hpvdt/zypher/README.md

# Zypher
Code and CAD of our 2019 ASME electronics system. Electronics hardware was designed in EAGLE, microcontroller code was prepared using the Arduino IDE. A mobile app prepared in MIT App Inventer 2 was used as the primary user interface.
