hpvdt/zypher/Hardware/Lighting line claculations.xlsx

Sheet: Sheet1
 |  | LED V Drop (V) |  |  | Peak Power (W) |  |  |  |  |  | Ref | 0.2
Light | LEDs Required | Min | Max | Peak Current (A) | Min | Max | Lines Required | LEDs per Line | Max V drop | Total Current to lights | Resistance needed on reg | Power across resistors | 95% power | Resistance needed on reg | Power across resistors
Head | 8 | 3.20 | 3.40 | 0.3500 | 1.12 | 1.19 | 1 | 8 | 27.20 | 0.350 | 0.571 | 0.07 | 0.332 | 0.602 | 0.07
High Beam | 2 | 9.00 | 12.00 | 1.0500 | 9.45 | 12.60 | 1 | 2 | 24.00 | 1.050 | 0.190 | 0.21 | 0.997 | 0.201 | 0.20
Left Ind. | 8 | 2.00 | 2.20 | 0.2625 | 0.53 | 0.58 | 1 | 8 | 17.60 | 0.263 | 0.762 | 0.05 | 0.249 | 0.802 | 0.05
Right Ind. | 8 | 2.00 | 2.20 | 0.2625 | 0.53 | 0.58 | 1 | 8 | 17.60 | 0.263 | 0.762 | 0.05 | 0.249 | 0.802 | 0.05
Tail | 8 | 1.70 | 1.90 | 0.2625 | 0.45 | 0.50 | 1 | 8 | 15.20 | 0.263 | 0.762 | 0.05 | 0.249 | 0.802 | 0.05
 |  |  |  |  |  |  |  |  | 28.45 | Max V
 | Max | Min
Battery V: | 12.3 | 11.1 | V | Power alloance | Max I | Min Resis |  |  | Res I have | Power | Current
 |  |  | 1.25 | 0.01 | 0.008 | 156.25 |  |  | 0.33 | 5 | 0.6060606061 |  |  | 1.400 | 3.143 | 6.16
I | R1 | R2 |  | 0.025 | 0.020 | 62.50 |  |  | 0.91 | 3 | 0.2197802198 |  |  | 3.000 | 1.467 | 13.20
3 | 0.6 | 1.363636364 |  | 0.03 | 0.024 | 52.08 |  |  | 1.2 | 3 | 0.1666666667 |  |  | 0.525 | 8.381 | 2.31
I indep | 2.0833 | 0.9167 |  | 0.04 | 0.032 | 39.06 |  |  | 2.4 | 2 | 0.08333333333
P indep | 2.604166667 | 1.145833333 |  | 0.05 | 0.040 | 31.25 |  |  | 190 |  | 1.052631579
 |  |  |  | 0.1 | 0.080 | 15.62
 |  |  |  | 0.125 | 0.100 | 12.50
 |  |  |  | 0.15 | 0.120 | 10.42
 |  |  |  | 0.2 | 0.160 | 7.81
 |  |  |  | 0.3 | 0.240 | 5.21
 |  |  |  | 0.333 | 0.266 | 4.69
 |  |  |  | 0.4 | 0.320 | 3.91
 |  |  |  | 0.5 | 0.400 | 3.12
 |  |  |  | 1 | 0.800 | 1.56

Sheet: Step Up
Vref | 1.23 | LED V Drop (V) |  |  | Peak Power (W)
Light | LEDs Required | Min | Max | Peak Current (A) | Min | Max | Lines Required | LEDs per Line | Max V drop | Total Current to lights | Resistance needed on reg | Power across resistors | Vout from step up | Max Current possible | R sense | D max | ET | I ind | L min (uH) | Spec Inductor
Head | 8 | 3.20 | 3.40 | 0.3500 | 1.12 | 1.19 | 1 | 8 | 27.20 | 0.350 | 3.51 | 0.43 | 28.43 | 0.776 | 3.514 | 0.651 | 123.8541638 | 2.330410418 | 54.592 | H220
High Beam | 2 | 9.00 | 12.00 | 1.0500 | 9.45 | 12.60 | 1 | 2 | 24.00 | 1.050 | 1.17 | 1.29 | 25.23 | 0.874 | 1.407 | 0.606 | 115.3823196 | 2.329367095 | 34.112 | H220
Left Ind. | 4 | 2.00 | 2.20 | 0.2625 | 0.53 | 0.58 | 1 | 4 | 8.80 | 0.263 | 4.69 | 0.32
Right Ind. | 4 | 2.00 | 2.20 | 0.2625 | 0.53 | 0.58 | 1 | 4 | 8.80 | 0.263 | 4.69 | 0.32
Tail | 8 | 1.70 | 1.90 | 0.2625 | 0.45 | 0.50 | 1 | 8 | 15.20 | 0.263 | 4.69 | 0.32 | 16.43 | 1.342 | 4.686 | 0.394 | 74.96467097 | 2.324402424 | -22.208 | H150
 |  |  |  |  |  |  |  |  | 28.45 | Max V |  |  |  |  | Vf | 0.5
 | Max | Min
Battery V: | 12.3 | 10.5 | V | Power alloance | Max I | Min Resis |  |  | Res I have | Power
 |  |  | 1.25 | 0.01 | 0.008 | 156.25 |  |  | 0.33 | 5
I | R1 | R2 |  | 0.025 | 0.020 | 62.50 |  |  | 0.91 | 3
3 | 0.6 | 1.363636364 |  | 0.03 | 0.024 | 52.08 |  |  | 1.2 | 3
I indep | 2.0833 | 0.9167 |  | 0.04 | 0.032 | 39.06 |  |  | 2.4 | 2
P indep | 2.604166667 | 1.145833333 |  | 0.05 | 0.040 | 31.25
 |  |  |  | 0.1 | 0.080 | 15.62
 |  |  |  | 0.125 | 0.100 | 12.50
 |  |  |  | 0.15 | 0.120 | 10.42
 |  |  |  | 0.2 | 0.160 | 7.81
 |  |  |  | 0.3 | 0.240 | 5.21
 |  |  |  | 0.333 | 0.266 | 4.69
 |  |  |  | 0.4 | 0.320 | 3.91
 |  |  |  | 0.5 | 0.400 | 3.12
 |  |  |  | 1 | 0.800 | 1.56
