hpvdt/zypher/Hardware/Zypher PCB.brd

## EAGLE design Hardware/Zypher PCB.brd (2019-11-08)

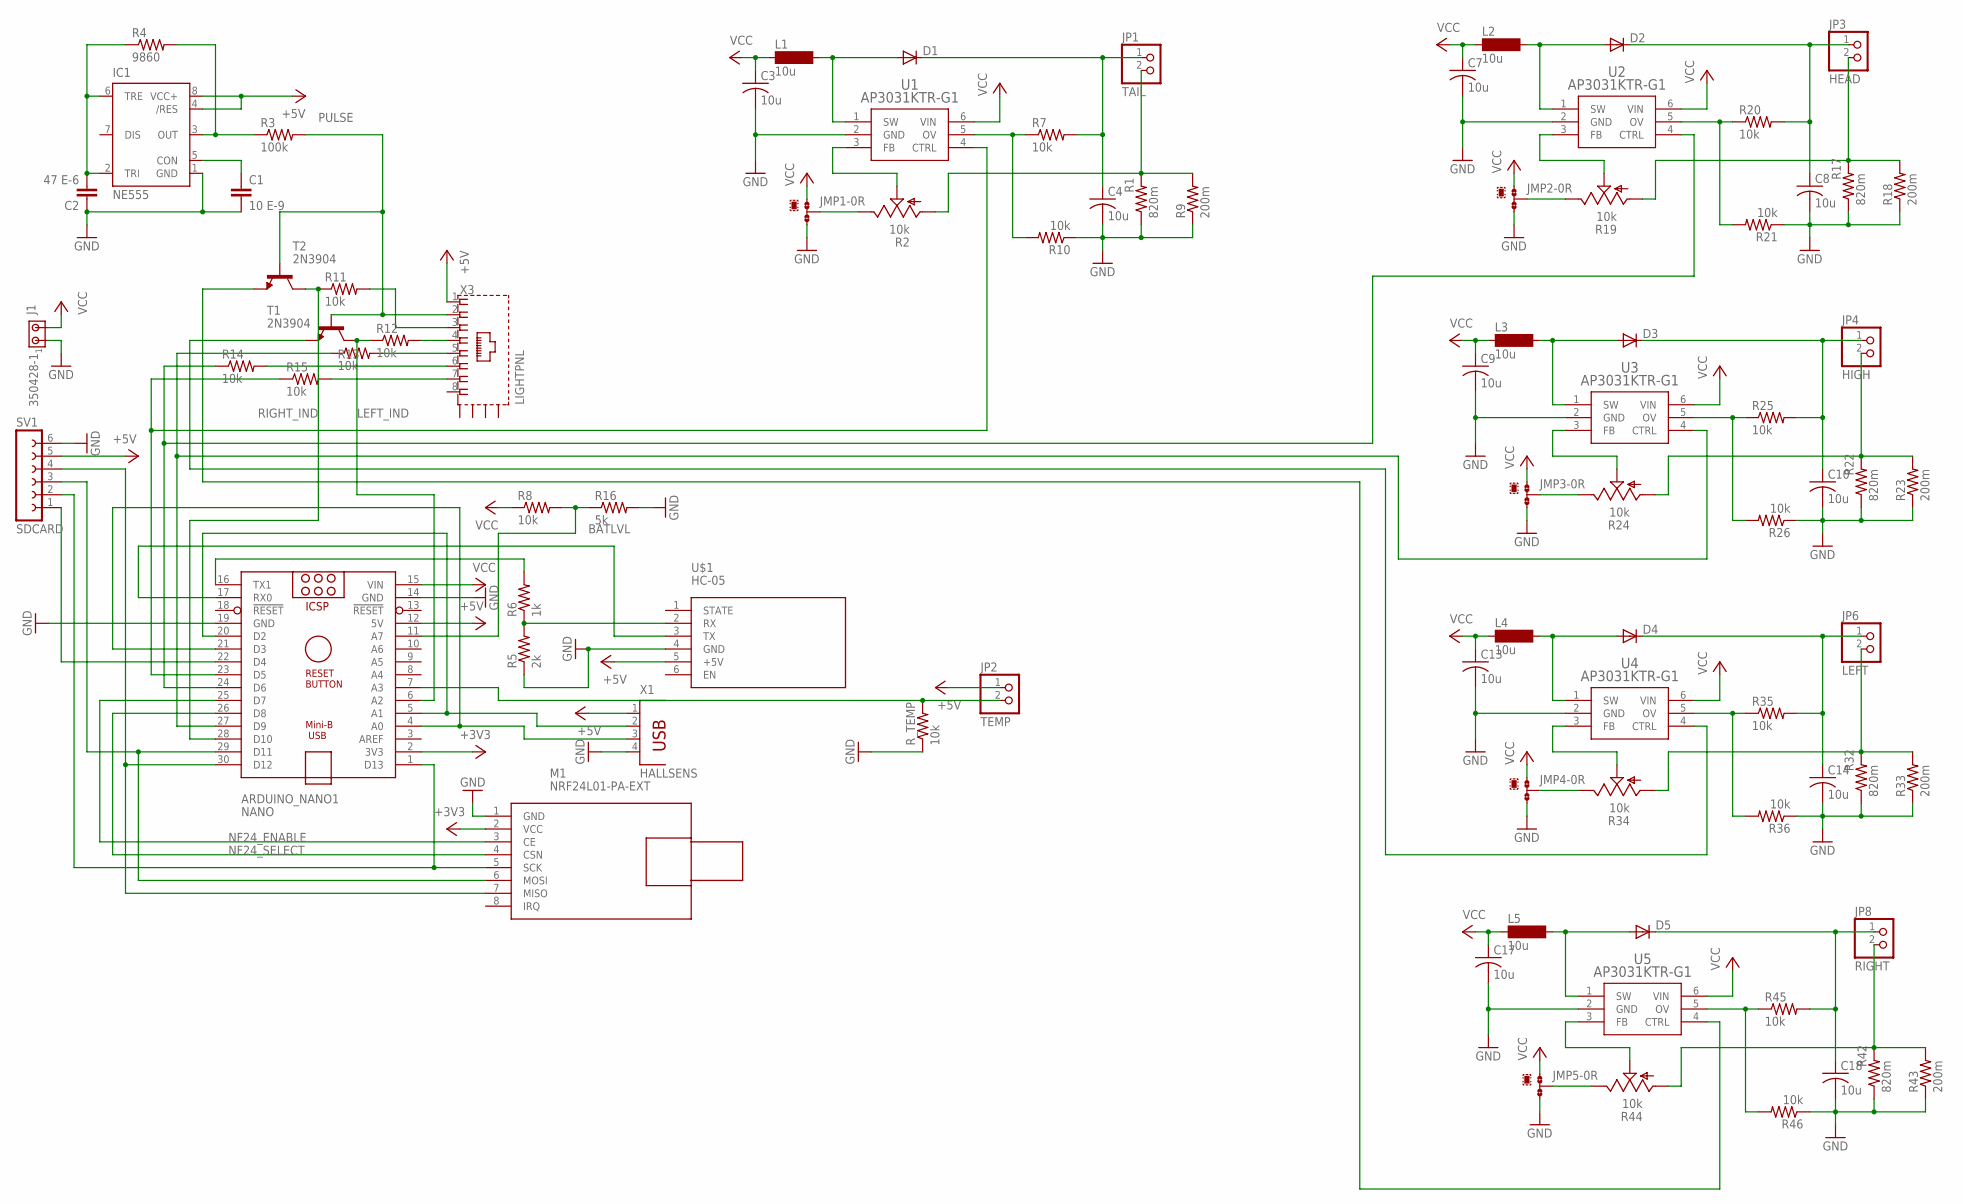
[picture p1: schematic Zypher PCB.sch]

Parts:
ARDUINO_NANO1: NANO; ARDUINO_NANO
C1: 10 E-9; C2.5-5
C2: 47 E-6; C2.5-5
C3, C4, C7, C8, C9, C10, C13, C14, C17, C18: 10u; C1206K
D1, D2, D3, D4, D5: DIODE-DO-214AC; DO-214AC
IC1: NE555; DIL-08
J1: 350428-1
JMP1, JMP2, JMP3, JMP4, JMP5: 0R-JUMPA; A0R-JMP
JP1: TAIL; 1X02
JP2: TEMP; 1X02
JP3: HEAD; 1X02
JP4: HIGH; 1X02
JP6: LEFT; 1X02
JP8: RIGHT; 1X02
L1, L2, L3, L4, L5: 10u; SD12K100
M1: NRF24L01-PA-EXT; WIRELESS-NRF24L01-PA-EXT
R1, R17, R22, R32, R42: 820m; R0603
R2, R19, R24, R34, R44: 10k; RJ9W
R3: 100k; 0207/7
R4: 9860; 0207/7
R5: 2k; 0204/7
R6: 1k; 0204/7
R7, R10, R20, R21, R25, R26, R35, R36, R45, R46: 10k; 0207/2V
R8, R11, R12, R13, R14, R15: 10k; 0207/7
R9, R18, R23, R33, R43: 200m; R0805
R16: 5k; 0207/7
R_TEMP: 10k; 0207/7
SV1: SDCARD; FE06W
T1, T2: 2N3904; TO92
U1, U2, U3, U4, U5: AP3031KTR-G1; SOT23-6
U$1: HC-05; WIRELESS-BLUETOOTH-HC-05
X1: HALLSENS; PN87520
X3: LIGHTPNL; RJ45-SHIELD1

Connections:
+3V3: ARDUINO_NANO1.2 (3V3), M1.2 (VCC)
+5V: ARDUINO_NANO1.12 (5V), IC1.4 (/RES), IC1.8 (VCC+), JP2.1, SV1.5, U$1.5 (+5V), X1.1, X3.1
BATLVL: ARDUINO_NANO1.11 (A7), R8.2, R16.1
CLK: ARDUINO_NANO1.1 (D13), M1.5 (SCK), SV1.2
GND: ARDUINO_NANO1.14 (GND), ARDUINO_NANO1.19 (GND), C1.2, C2.1, C3.2, C4.2, C7.2, C8.2, C9.2, C10.2, C13.2, C14.2, C17.2, C18.2, IC1.1 (GND), J1.1, JMP1.3, JMP2.3, JMP3.3, JMP4.3, JMP5.3, M1.1 (GND), R1.1, R5.1, R9.1, R10.1, R16.2, R17.1, R18.1, R21.1, R22.1, R23.1, R26.1, R32.1, R33.1, R36.1, R42.1, R43.1, R46.1, R_TEMP.1, SV1.6, U1.2 (GND), U2.2 (GND), U3.2 (GND), U4.2 (GND), U5.2 (GND), U$1.4 (GND), X1.4
HALL1: ARDUINO_NANO1.4 (A0), ARDUINO_NANO1.21 (D3), X1.3
HALL2: ARDUINO_NANO1.5 (A1), ARDUINO_NANO1.20 (D2), X1.2
HEAD_CTRL: ARDUINO_NANO1.24 (D6), R14.1, U2.4 (CTRL)
HIGH_CTRL: ARDUINO_NANO1.27 (D9), R13.1, U3.4 (CTRL)
LEFT+: C14.1, D4.C, JP6.1, R35.2
LEFT-: JP6.2, R32.2, R33.2, R34.A
LEFT_CTRL: T1.3 (E), U4.4 (CTRL)
LEFT_IND: ARDUINO_NANO1.6 (A2), R12.1, T1.1 (C)
MISO: ARDUINO_NANO1.30 (D12), M1.7 (MISO), SV1.4
MOSI: ARDUINO_NANO1.29 (D11), M1.6 (MOSI), SV1.3
unnamed: D1.A, L1.2, U1.1 (SW)
unnamed: C1.1, IC1.5 (CON)
unnamed: C4.1, D1.C, JP1.1, R7.2
unnamed: C2.2, IC1.2 (TRI), IC1.6 (TRE), R4.1
unnamed: IC1.3 (OUT), R3.1, R4.2
unnamed: R2.S, U1.3 (FB)
unnamed: JP1.2, R1.2, R2.A, R9.2
unnamed: JMP1.2, R2.E
unnamed: R5.2, R6.1, U$1.2 (RX)
unnamed: R7.1, R10.2, U1.5 (OV)
unnamed: R14.2, X3.6
unnamed: R13.2, X3.5
unnamed: R11.2, X3.3
unnamed: R12.2, X3.4
unnamed: R15.2, X3.7
unnamed: D2.A, L2.2, U2.1 (SW)
unnamed: C8.1, D2.C, JP3.1, R20.2
unnamed: JP3.2, R17.2, R18.2, R19.A
unnamed: R19.S, U2.3 (FB)
unnamed: JMP2.2, R19.E
unnamed: R20.1, R21.2, U2.5 (OV)
unnamed: D3.A, L3.2, U3.1 (SW)
unnamed: C10.1, D3.C, JP4.1, R25.2
unnamed: JP4.2, R22.2, R23.2, R24.A
unnamed: R24.S, U3.3 (FB)
unnamed: JMP3.2, R24.E
unnamed: R25.1, R26.2, U3.5 (OV)
unnamed: D4.A, L4.2, U4.1 (SW)
unnamed: R34.S, U4.3 (FB)
unnamed: JMP4.2, R34.E
unnamed: R35.1, R36.2, U4.5 (OV)
unnamed: D5.A, L5.2, U5.1 (SW)
unnamed: R44.S, U5.3 (FB)
unnamed: JMP5.2, R44.E
unnamed: R45.1, R46.2, U5.5 (OV)
NF24_ENABLE: ARDUINO_NANO1.25 (D7), M1.3 (CE)
NF24_SELECT: ARDUINO_NANO1.26 (D8), M1.4 (CSN)
PULSE: R3.2, T1.2 (B), T2.2 (B), X3.2
RIGHT+: C18.1, D5.C, JP8.1, R45.2
RIGHT-: JP8.2, R42.2, R43.2, R44.A
RIGHT_CTRL: T2.3 (E), U5.4 (CTRL)
RIGHT_IND: ARDUINO_NANO1.28 (D10), R11.1, T2.1 (C)
RX: ARDUINO_NANO1.17 (RX0), U$1.3 (TX)
SD_SEL: ARDUINO_NANO1.22 (D4), SV1.1
TAIL_CTRL: ARDUINO_NANO1.23 (D5), R15.1, U1.4 (CTRL)
TEMP: ARDUINO_NANO1.7 (A3), JP2.2, R_TEMP.2
TX: ARDUINO_NANO1.16 (TX1), R6.2
VCC: ARDUINO_NANO1.15 (VIN), C3.1, C7.1, C9.1, C13.1, C17.1, J1.2, JMP1.1, JMP2.1, JMP3.1, JMP4.1, JMP5.1, L1.1, L2.1, L3.1, L4.1, L5.1, R8.1, U1.6 (VIN), U2.6 (VIN), U3.6 (VIN), U4.6 (VIN), U5.6 (VIN)

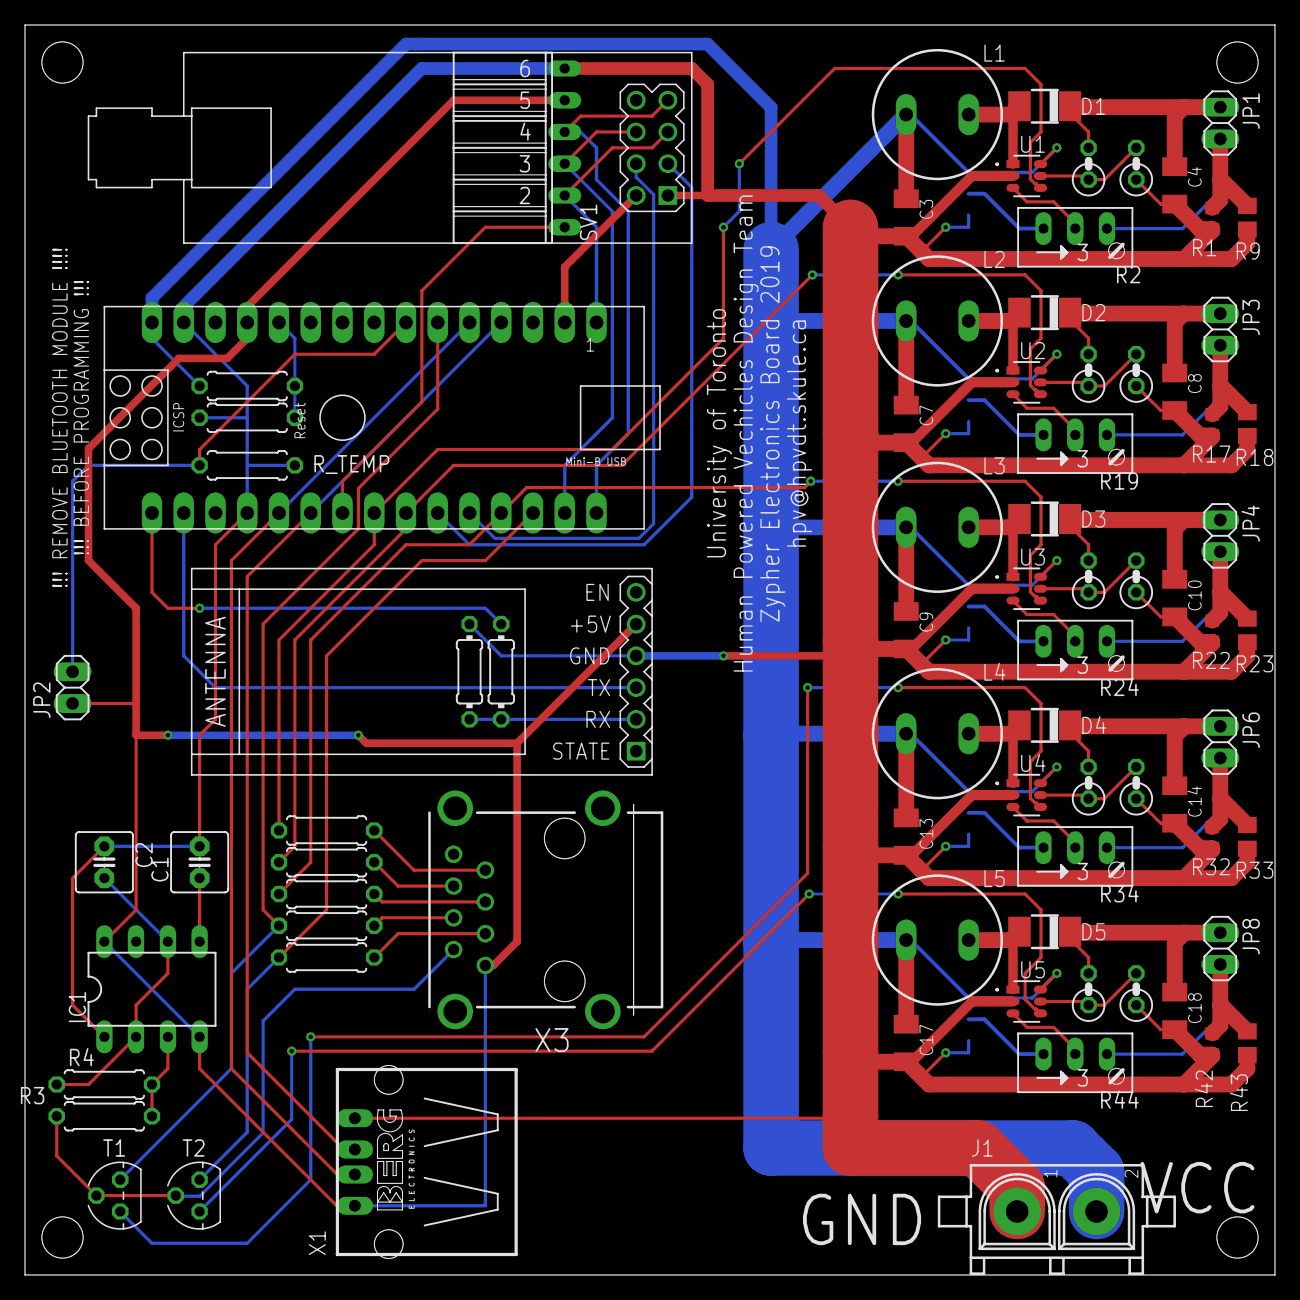
[picture p2: board Zypher PCB.brd from above]

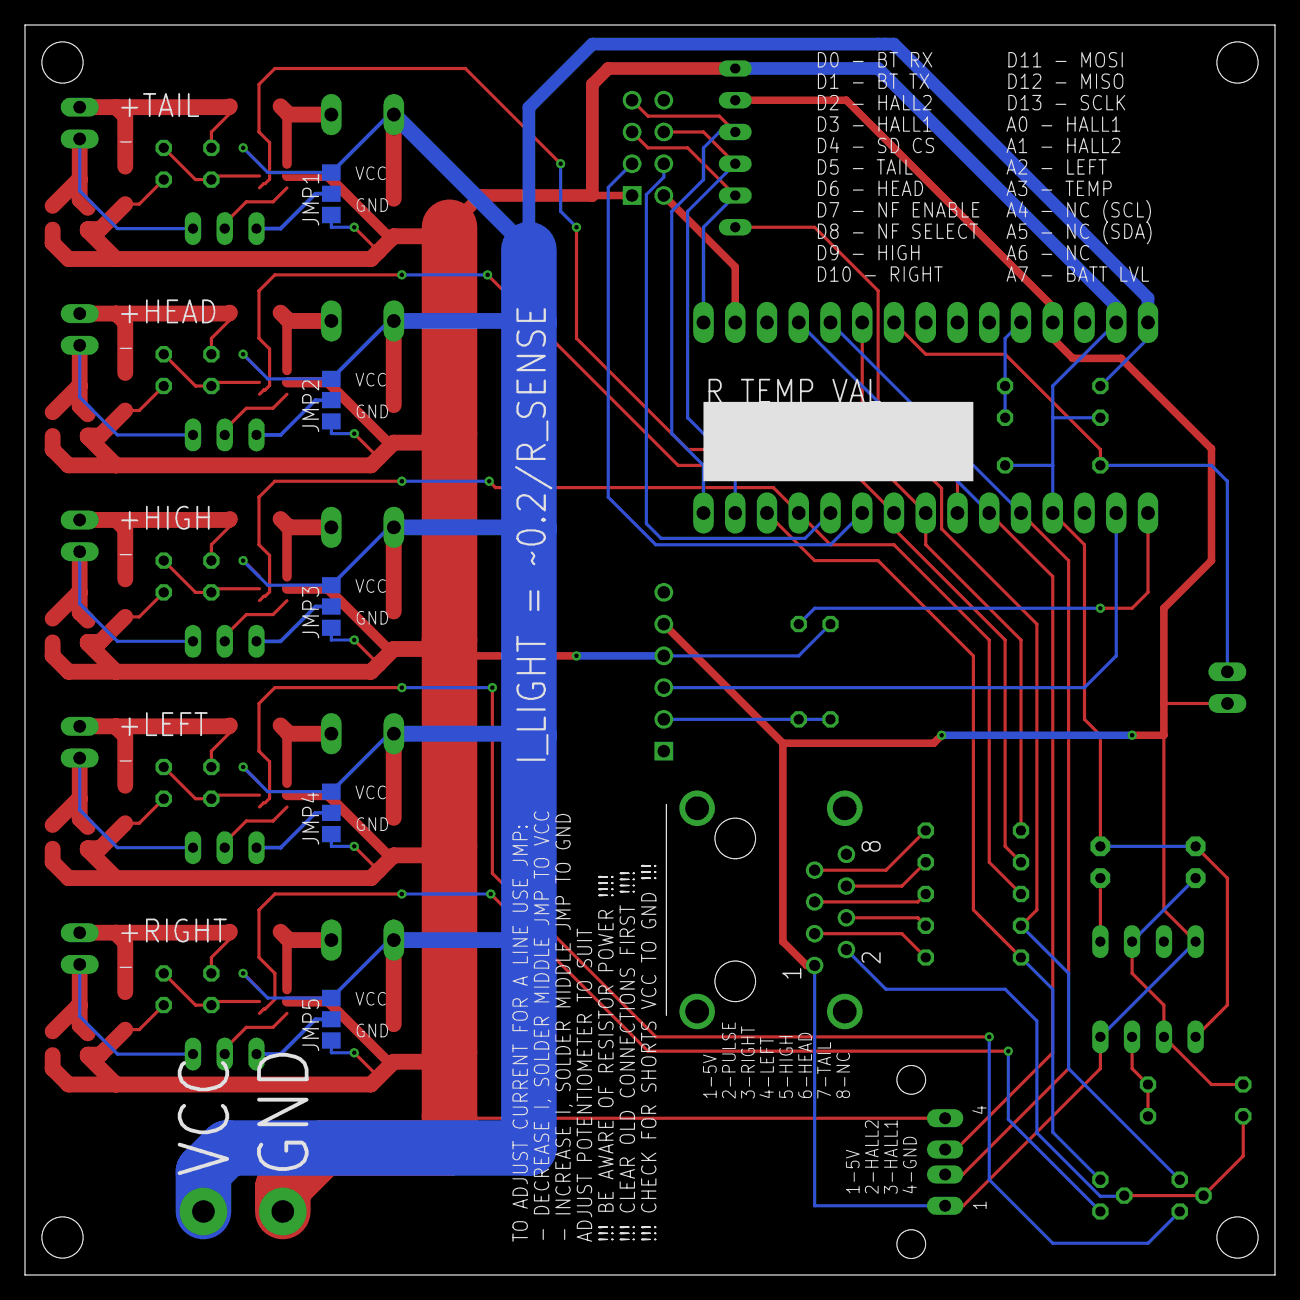
[picture p3: board Zypher PCB.brd from below]

Board: 2 copper layers, 100.0 x 100.0 mm, 85 parts (5 on the bottom side), 63 nets.
