hpvdt/zypher/Hardware/Lighting Schematic.brd

## EAGLE design Hardware/Lighting Schematic.brd (2019-11-08)

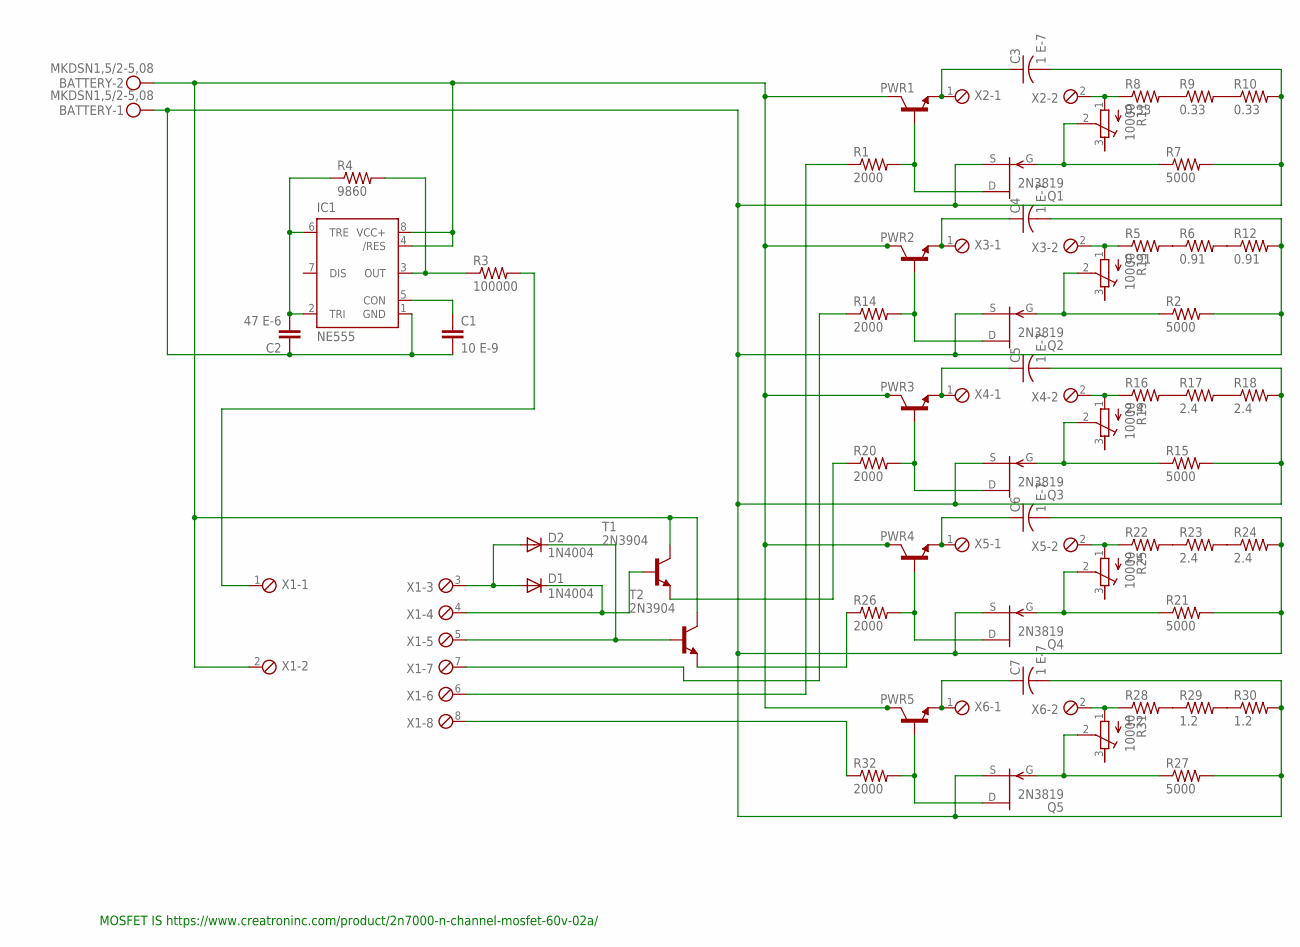
[picture p4: schematic Lighting Schematic.sch]

Parts:
BATTERY: MKDSN1,5/2-5,08
C1: 10 E-9; C2.5-5
C2: 47 E-6; C2.5-5
C3, C4, C5, C6, C7: 1 E-7; C075-052X106
D1, D2: 1N4004; DO41-10
IC1: NE555; DIL-08
PWR1, PWR2, PWR3, PWR4, PWR5: -NPN-TO220V; TO220V
Q1, Q2, Q3, Q4, Q5: 2N3819; TO92
R1, R14, R20, R26, R32: 2000; 0207/15
R2, R7, R15, R21, R27: 5000; 0207/10
R3: 100000; 0207/10
R4: 9860; 0207/10
R5, R6, R12: 0.91; P0817V
R8, R9, R10: 0.33; P0817V
R11, R13, R19, R25, R31: 10000; RTRIM3296W
R16, R17, R18, R22, R23, R24: 2.4; P0817V
R28, R29, R30: 1.2; P0817V
T1, T2: 2N3904; TO92
X1: MPT8; 8POL254
X2, X3, X4, X5, X6: MPT2; 2POL254

Connections:
GND: BATTERY.1, C1.2, C2.1, C3.2, C4.2, C5.2, C6.2, C7.2, IC1.1 (GND), Q1.3 (S), Q2.3 (S), Q3.3 (S), Q4.3 (S), Q5.3 (S), R2.2, R7.2, R10.2, R12.2, R15.2, R18.2, R21.2, R24.2, R27.2, R30.2
HEAD+: C4.1, PWR2.3 (E), X3.1
HEAD-: R5.1, R13.1 (A), X3.2
HIGH+: C3.1, PWR1.3 (E), X2.1
HIGH-: R8.1, R11.1 (A), X2.2
LEFT+: C5.1, PWR3.3 (E), X4.1
LEFT-: R16.1, R19.1 (A), X4.2
unnamed: R5.2, R6.1
unnamed: C1.1, IC1.5 (CON)
unnamed: R6.2, R12.1
unnamed: C2.2, IC1.2 (TRI), IC1.6 (TRE), R4.1
unnamed: IC1.3 (OUT), R3.1, R4.2
unnamed: D1.A, D2.A, X1.3
unnamed: D1.C, T1.2 (B), X1.4
unnamed: D2.C, T2.2 (B), X1.5
unnamed: R3.2, X1.1
unnamed: R8.2, R9.1
unnamed: R9.2, R10.1
unnamed: PWR1.1 (B), Q1.1 (D), R1.2
unnamed: Q1.2 (G), R7.1, R11.2 (S)
unnamed: PWR2.1 (B), Q2.1 (D), R14.2
unnamed: Q2.2 (G), R2.1, R13.2 (S)
unnamed: R1.1, X1.6
unnamed: R14.1, X1.7
unnamed: R26.1, T2.3 (E)
unnamed: R32.1, X1.8
unnamed: R16.2, R17.1
unnamed: R17.2, R18.1
unnamed: PWR3.1 (B), Q3.1 (D), R20.2
unnamed: Q3.2 (G), R15.1, R19.2 (S)
unnamed: R22.2, R23.1
unnamed: R23.2, R24.1
unnamed: PWR4.1 (B), Q4.1 (D), R26.2
unnamed: Q4.2 (G), R21.1, R25.2 (S)
unnamed: R28.2, R29.1
unnamed: R29.2, R30.1
unnamed: PWR5.1 (B), Q5.1 (D), R32.2
unnamed: Q5.2 (G), R27.1, R31.2 (S)
unnamed: R20.1, T1.3 (E)
RIGHT+: C6.1, PWR4.3 (E), X5.1
RIGHT-: R22.1, R25.1 (A), X5.2
TAIL+: C7.1, PWR5.3 (E), X6.1
TAIL-: R28.1, R31.1 (A), X6.2
VCC: BATTERY.2, IC1.4 (/RES), IC1.8 (VCC+), PWR1.2 (C), PWR2.2 (C), PWR3.2 (C), PWR4.2 (C), PWR5.2 (C), T1.1 (C), T2.1 (C), X1.2

Notes on the sheet:
MOSFET IS https://www.creatroninc.com/product/2n7000-n-channel-mosfet-60v-02a/

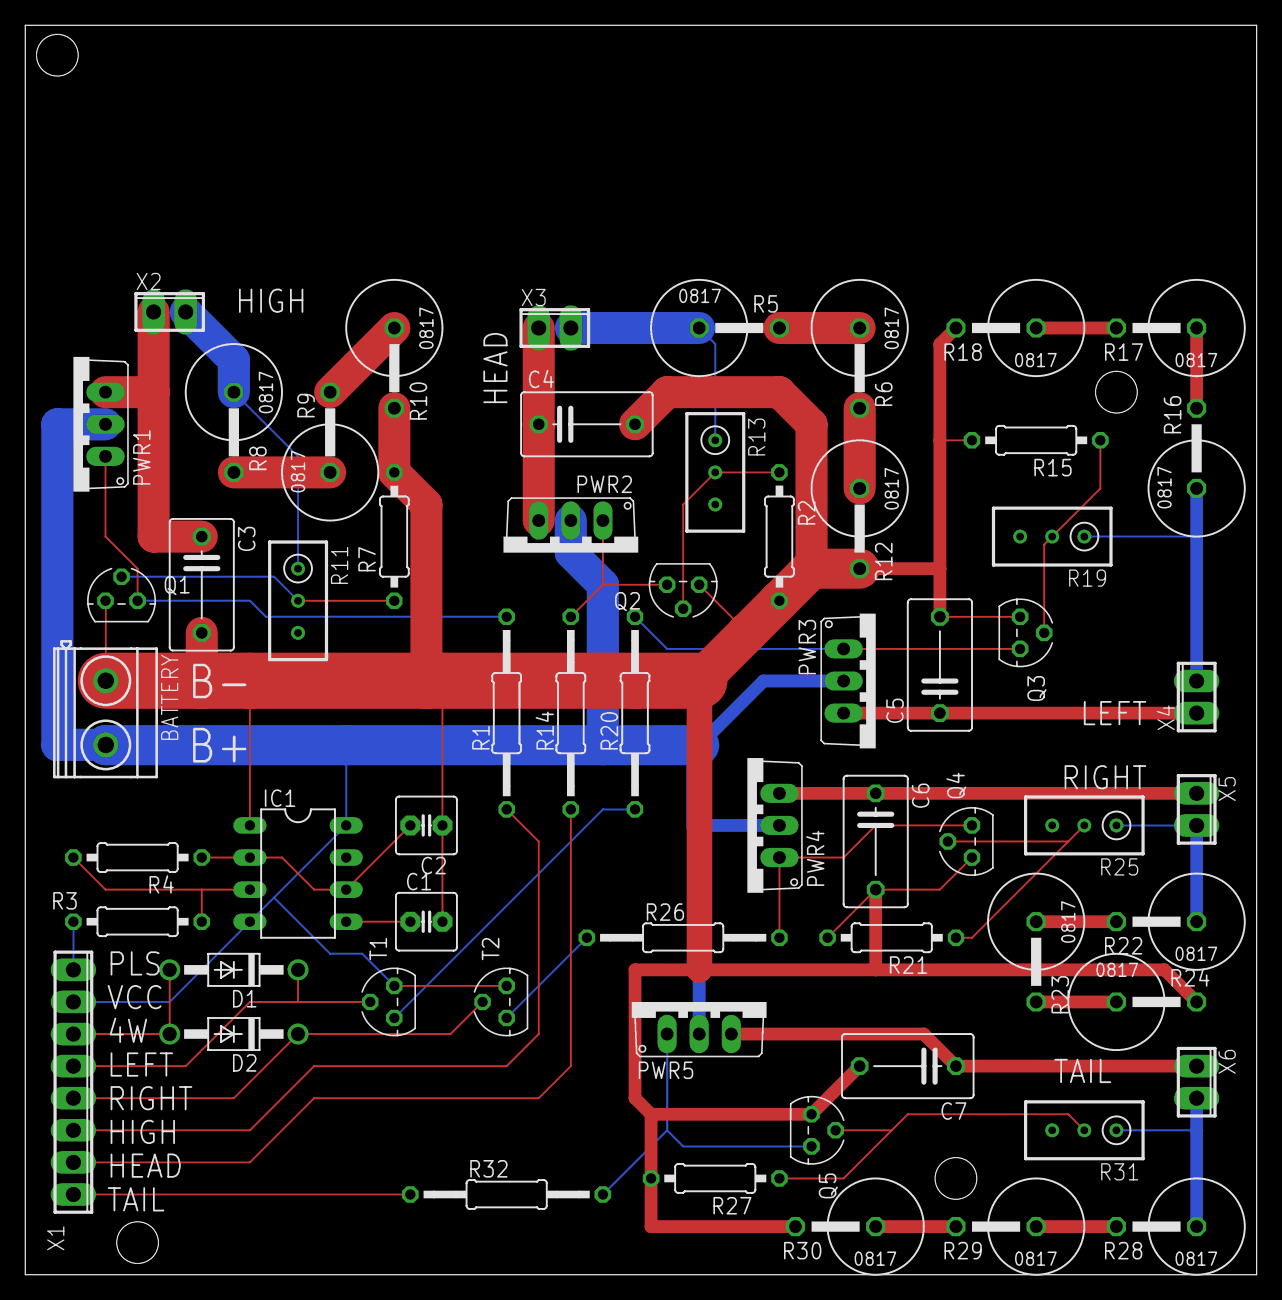
[picture p5: board Lighting Schematic.brd from above]

Board: 2 copper layers, 97.5 x 98.9 mm, 61 parts (0 on the bottom side), 44 nets.
