hpvdt/zypher/Hardware/Lighting IC test.brd

## EAGLE design Hardware/Lighting IC test.brd (2019-11-08)

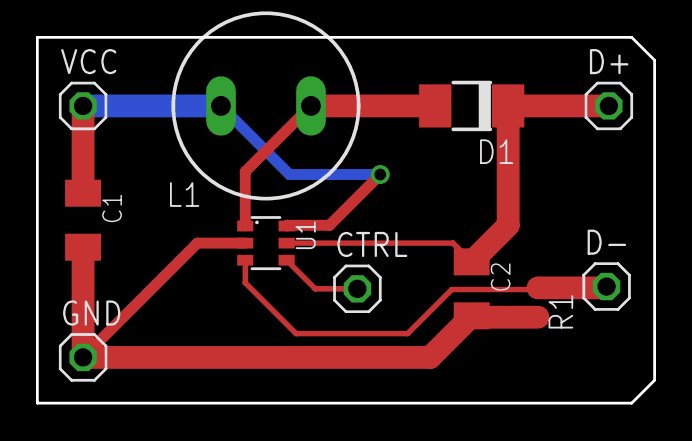
[picture p6: board Lighting IC test.brd from above]

Board: 2 copper layers, 34.3 x 20.3 mm, 11 parts (0 on the bottom side), 6 nets.

Parts:
C1, C2: C1206K
CTRL: 1X01
D1: DO-214AC
D+: 1X01
D-: 1X01
GND: 1X01
L1: SD12K100
R1: R0603
U1: SOT23-6
VCC: 1X01

Connections:
CONTROL: CTRL.1, U1.4
FEEDBACK: D-.1, R1.1, U1.3
GND: C1.2, C2.2, GND.1, R1.2, U1.2
SWITCH: D1.A, L1.1, U1.1
VCC: C1.1, L1.2, U1.6, VCC.1
VOUT: C2.1, D1.C, D+.1, U1.5
