hpvdt/zypher/(commit log)

2019-11-08 Initial commit
    Upload of the files used.
    [Lighting IC test V2.brd, Lighting IC test.brd, Lighting Schematic.brd, Lighting Schematic.sch, Lighting line claculations.xlsx, Zypher PCB for MIE.brd, Zypher PCB.brd, Zypher PCB.sch]
2021-06-07 Upload of Zypher files
    [Lighting IC test V2.brd, Lighting IC test.brd, Lighting Schematic.brd, Lighting Schematic.sch, Lighting line claculations.xlsx, Zypher PCB for MIE.brd, Zypher PCB.brd, Zypher PCB.sch]
